julianpas/esphome-supramatic/docs/UAP1-HCP.pdf

# 24 V DC

max.

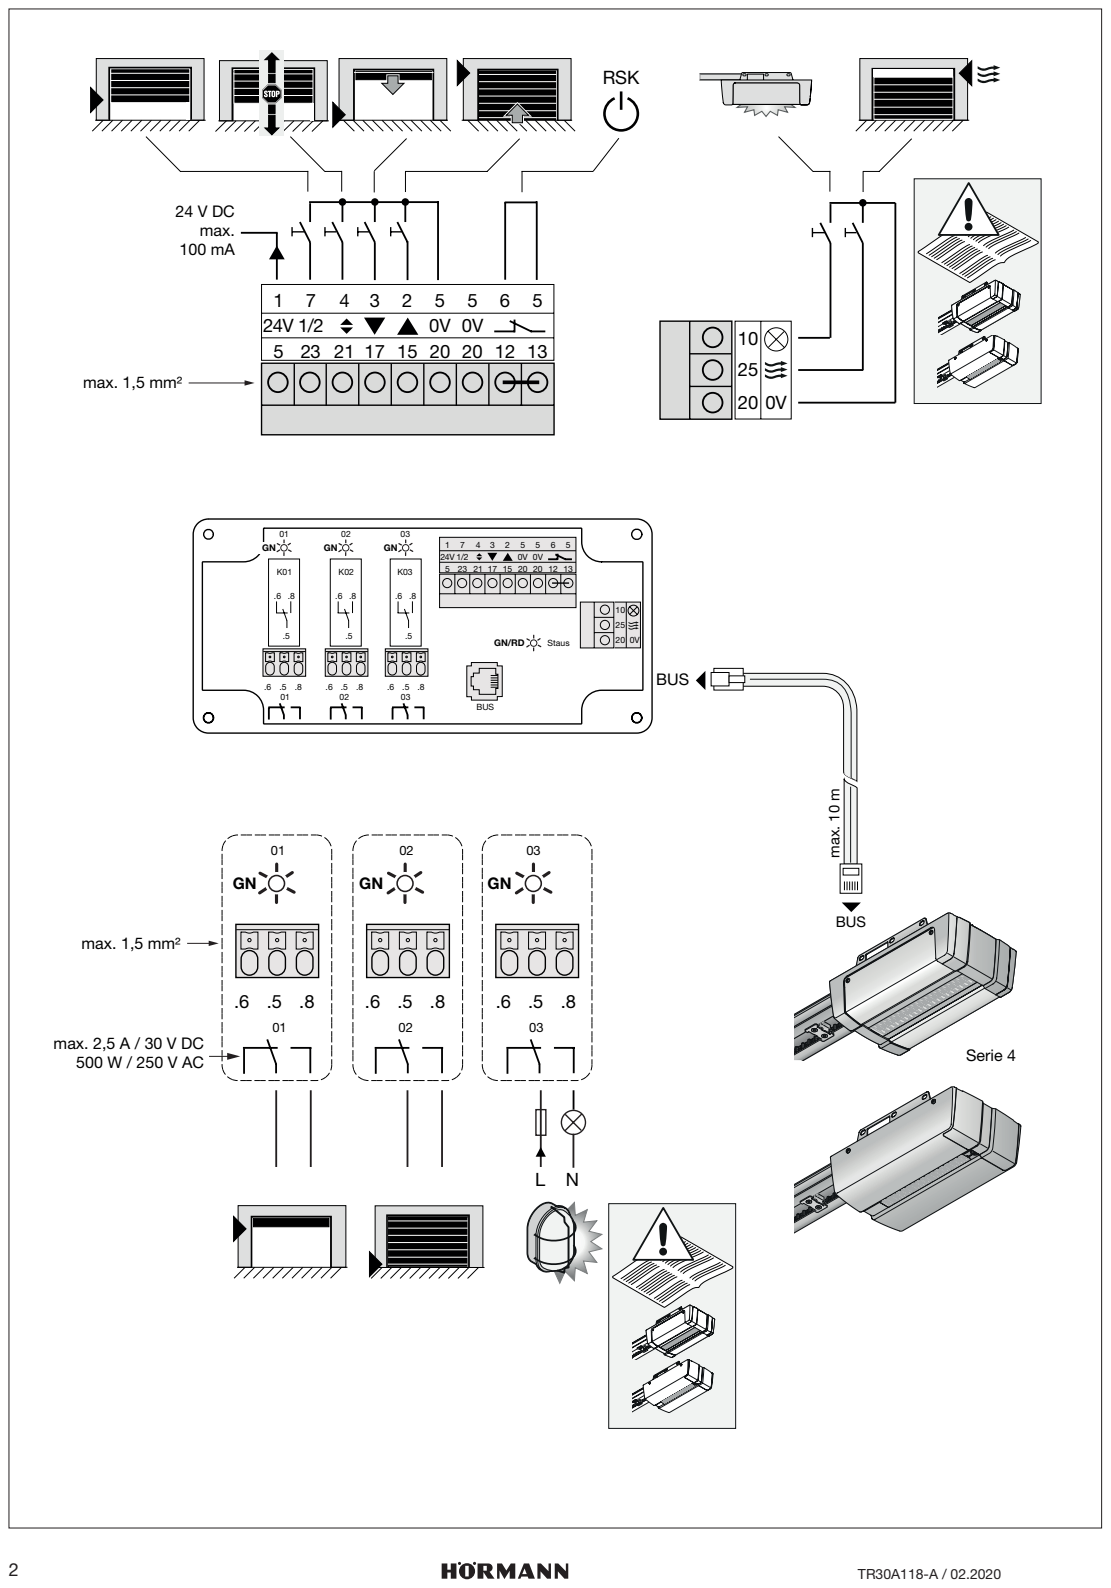
[picture p5: page 1]
Serie 4; max. 1,5 mm²; RSK; max. 2,5 A / 30 V DC 500 W / 250 V AC; BUS; BUS max. 10; Staus
