julianpas/esphome-supramatic/(commit log)

2023-04-09 Add schematic file
2023-04-20 Mostly working prototype
2023-04-20 Add BLE based position tracking
    Listen for BLE advertisments by the door motor to fill in the gaps in the data that is provided by the UAP board.
